andybusse/power-hw/gerbers/README.txt

Student Robotics
Contact: Richard Barlow
Email:   rbarlow@studentrobotics.org
Phone:   XXXXXXXXXXXX
--------------------------------------------------------------------------------
Board Reference:  srobo_power
Board Issue:      A
--------------------------------------------------------------------------------
Board Details:
Bare Board Test:      Yes
Layers:               2
Copper Weight:        1oz
Finish:               Gold
Material:             1.6mm FR4
Solder Resist:        GREEN on 2 sides
Silk Screen:          WHITE on 2 sides
Panelisation:         Manufacturing Panels
Circuits per Panel:   1
--------------------------------------------------------------------------------
Please step up the boards to fit on a panel size no greater than 285mm x 185mm
Add 1mm fiducials to 3 corners of the panel on the top side.
Place 3mm locating holes in each corner of the panel border.
Return the stepped up gerber for the solder paste (*paste.gbr) - Please include
the postions of the fiducials on the stepped up gerber.
--------------------------------------------------------------------------------
Layer Order:
front
back
--------------------------------------------------------------------------------
Gerber Files:
power.front.gbr       - Top Copper Layer
power.back.gbr        - Bottom Copper Layer
power.frontmask.gbr   - Solder Mask Top
power.backmask.gbr    - Solder Mask Bottom
power.frontpaste.gbr  - Solder Paste Top
power.backpaste.gbr   - Solder Paste Bottom
power.frontsilk.gbr   - Silk Screen Top
power.backsilk.gbr    - Silk Screen Bottom
power.outline.gbr     - Board Outline
power.fab.gbr         - Fabrication/Drill Drawing
power.plated-drill.cnc   - Plated Hole Drill Information
power.unplated-drill.cnc - Unplated Hole Drill Information
--------------------------------------------------------------------------------
If there are any problems please contact Student Robotics using the details at
the top of this file.
