andybusse/power-hw/padding.dxf

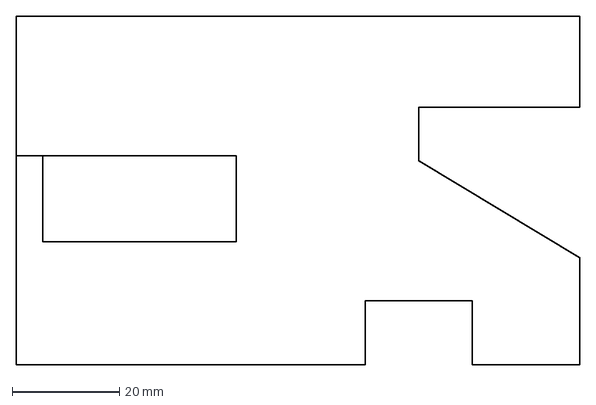
[picture p1: CAD file, 2011-02-26]
padding.dxf
105.0 x 65.0 mm
