andybusse/power-hw/case-devel.dxf

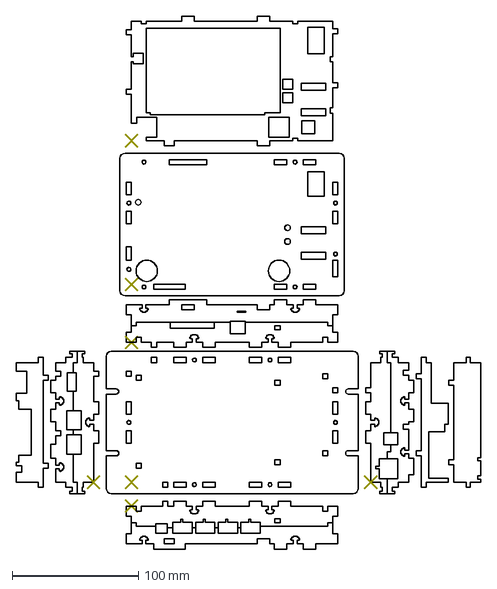
[picture p2: CAD file, 2010-12-02]
case-devel.dxf
368.8 x 423.0 mm
