andybusse/power-hw/(list of files, drawings)

Other design files:
power.pcb
usb-riser/gerbers/outline.pcb
usb-riser/usb-riser.pcb
