andybusse/power-hw/(commit log)

2010-07-20 Add components & sric submodule. Add other misc file
    Ignore itermediate files created by gsch2pcb and backup files from both
    gschem and PCB. Add projectrc/gafrc files for managing symbol/package
    libraries.
2010-07-20 Start schematic. Add battery connector
    Also removed titleblock
    [power.sch]
2010-07-21 Add fuse from the battery. Pull components repo with fuse footprint
    [power.sch]
2010-07-22 Add comment to battery fuse outlining the type/rating to be used
    [power.sch]
2010-07-22 Add netname to fuse protected battery voltage rail
    [power.sch]
2010-07-22 Add reverse polarity protection FET. Pull updated components repo for D_PAK
    [power.sch]
2010-07-22 Change battery connector to sr-cn-battcon. Remove footprint for now
    [power.sch]
2010-07-22 Add charger socket and fuse
    [power.sch]
2010-07-22 Add battery current sense resistor, connect charger to battery
    [power.sch]
2010-07-22 Add FET to detect when the charger is plugged in
    Use a FET to buffer the signal from the charger socket instead
    of just using that pin as a pull-down into the MSP to protect against
    breaking things if the charger is mis-wired. When the battery or charger
    is connected the wrong way around a small current will flow through the
    100k resistor, I think there'll be no problem with this.
    [power.sch]
2010-07-22 Rename 'Vbatt' net to '12V'
    [power.sch]
2010-07-22 Add footprint and comment attribute to charger socket
    [power.sch]
2010-07-22 Add 12V logic rail protected by a 1A fuse
    The 1A fuse will allow roughly 2.4A to be drawn from the 5V BB/USB
    rail. It will take over 30 mins to blow with 2A flowing through it.
    [power.sch]
2010-07-22 Add logic power switch between the 12V and 12V_logic rails
    [power.sch]
2010-07-22 Add 3.3V linear reg
    Use a linear reg off the 12V rail it's only powering the MSP and
    the SRIC LVDS IC. It could be a smaller reg off the 5V rail but it
    would mean the 5V rail could not be controlled by the MSP.
    [power.sch]
2010-07-22 Add power LED to 3.3V rail
    [power.sch]
2010-07-22 Add power LED to 12V rail
    [power.sch]
2010-07-23 Add fuses to protect SRIC 12V line
    Fuse the 'IN' and 'OUT' socket individually. The fuses are rated to
    protect the cable and will allow a maximum of 3.7A to be drawn over
    the interconnect. This works out as 925mA per conductor.
    [power.sch]
2010-07-23 Add motor/pwm rail camcons
    Three camcons for up to four motor boards + a PWM board or two.
    [power.sch]
2010-07-23 Add motor/pwm rail control FET
    [power.sch]
2010-07-23 Add charge-pump for driving motor/pwm rail FET
    As I'm using an n-channel FET to switch the motor/pwm rail a charge-
    pump is required to obtain a high voltage for driving the gate.
    This charge pump uses a dual op-amp as a relaxation oscillator and
    unity gain buffer. The buffer drives a cap/diode network to give
    ~22V on the output.
    [power.sch]
2010-07-23 Add FETs to drive motor/pwm rail FET
    Add a couple of inverters to drive the gate of the motor/pwm rail
    FET.
    [power.sch]
2010-07-23 Add 100k pull-down to input of motor/pwm rail control circuit
    Don't want this thing turning on accidentally
    [power.sch]
2010-07-23 Add 100k pull-up to charger detection FET
    Now that the 3.3V rail exists, there's somewhere to pull it up to.
    [power.sch]
2010-07-23 Add Makefile copied from the motor-hw.git repo
2010-07-23 Add beagleboard symbols
    [power.sch]
2010-07-23 Add values to charge-pump op-amps. Remove incorrect footprint attribute
    Hmm, seems some of the gEDA symbols have footprints already assigned, crazy.
    [power.sch]
2010-07-23 Add SRIC 8P8C connectors and connect up to 12V rail
    Had to add them in separately to allow the power rails to be connected properly.
    [power.sch]
2010-07-23 Give all SRIC lines from 8P8C sockets netnames
    [power.sch]
2010-07-23 Shift SRIC stuff away from everything else, it's going to be quite big
    [power.sch]
2010-07-23 Add SRIC LVDS drivers
    [power.sch]
2010-07-23 Add SRIC data input line termination and protection
    [power.sch]
2010-07-23 Add termination and protection to SRIC token input line
    [power.sch]
2010-07-23 Add protection to SRIC token out lines and connect them to the LVDS driver
    [power.sch]
2010-07-23 Add protection to SRIC data output lines and connect to LVDS driver
    [power.sch]
2010-07-23 Permanently enable token LVDS driver
    [power.sch]
2010-07-23 Add power and decoupling caps for SRIC LVDS IC
    [power.sch]
2010-07-23 Reposition SRIC RJ45 socket values
    [power.sch]
2010-07-23 Add net names to data tx/rx and token in/out lines from LVDS IC
    [power.sch]
2010-07-24 Move 12V rail power LED to make space for current sense circuit
    [power.sch]
2010-07-24 Set value and footprint of current sense resistor
    [power.sch]
2010-07-24 Add filter across current sense resistor
    Has a breakpoint of ~1.7kHz. The signal will be filtered more before
    it enters the MSP. This is just to remove the very high frequency
    components from the edges of the PWM on the motor boards.
    [power.sch]
2010-07-24 Add current sense amplifier to measure current to/from the battery
    The amplifier has a gain of 50 and the sense resistor (1m ohm) gives
    1mV/A therefore the output of the amplifier has the scale 50mV/A.
    [power.sch]
2010-07-25 Add UART and RESET netnames to BB expansion header
    [power.sch]
2010-07-25 Add LPF to output of current sense amp
    Has a breakpoint of 1.026kHz
    [power.sch]
2010-07-25 Add potential divider to obtain current sense diff. amp. reference voltage
    The potential divider gives 0.25V from the VREF+ pin on the MSP which
    will be at 1.5V when measuring the current.
    [power.sch]
2010-07-25 Add netname to current sense output
    [power.sch]
2010-07-26 Add potential divider to measure battery voltage
    [power.sch]
2010-07-27 Add LCD data and backlight connectors to schematic
    [power.sch]
2010-07-27 Add 5V power switching circuitry to LCD 5V input
    The datasheet for the display says that the 5V rail must be applied
    after the 2.5V rail.
    [power.sch]
2010-07-27 Add values and footprints to the LCD connectors
    [power.sch]
2010-07-27 Add 2.5V LDO regulator for LCD power
    [power.sch]
2010-07-27 Increase space between the beagleboard and LCD symbols to fit in translators
    [power.sch]
2010-07-27 Add LCD backlight SMPS
    [power.sch]
2010-07-27 Disconnect backlight driver shutdown pin from 5V rail. Add pull-down
    We need to be able to turn the backlight driver on after everything
    else is powered up and the output cap of the driver has charged to
    prevent a large inrush current. It also means we can vary the
    brightness of the backlight.
    [power.sch]
2010-07-27 Move backlight SMPS higher up to allow for level translators
    [power.sch]
2010-07-27 Add LCD level translators
    [power.sch]
2010-07-27 Add power symbols for level translators
    [power.sch]
2010-07-27 Change all occurrences of 'IC' refdeses to 'U' refdeses to keep consistency
    [power.sch]
2010-07-27 Reposition level translator refdeses and values
    [power.sch]
2010-07-27 Set value of 2.5V LDO regulator
    [power.sch]
2010-07-27 Add 2u2 cap to the 5V rail just before the LCD power FET
    [power.sch]
2010-07-28 Add values to the beagleboard expansion and LCD header symbols
    [power.sch]
2010-07-29 Rename LCD 1.8V rail to '1V8_LCD' and add netname to main 1V8 rail
    [power.sch]
2010-07-29 Add EEPROM for identifying the power board from the beagleboard
    The BB SRM says that we should have an EEPROM connected to the I2C
    lines of the expansion header so that the board can be identified
    and pin muxes set appropriately.
    [power.sch]
2010-07-29 Add MSP430F247
    [power.sch]
2010-07-29 Connect power and add decoupling caps to MSP
    [power.sch]
2010-07-29 Connect analogue reference voltages to MSP and reference decoupling caps
    [power.sch]
2010-07-29 Connect Vsense and Isense nets to MSP analogue inputs
    [power.sch]
2010-07-29 Add piezo sounder to TA1 outputs
    Can drive it either differentially (which should be louder) by
    populating the resistor to the P1.6 TA1 pin or single-ended with
    the resistor to ground.
    [power.sch]
2010-07-29 Add footprint to piezo buzzer. Add comment explaining piezo resistors
    [power.sch]
2010-07-29 Connect SRIC to MSP, use same UART as pc-sric adapter board
    [power.sch]
2010-07-29 Tie reset line high with 100k resistor
    [power.sch]
2010-07-29 Add 4-wire JTAG programming header for MSP
    [power.sch]
2010-07-29 Give JTAG programming header a value and footprint
    [power.sch]
2010-07-29 Shift 'TX_EN', 'TO' and 'TI' SRIC lines to the same pins as the pc-sric board
    Not massively important but might prove useful.
    [power.sch]
2010-07-29 Add 2 bit level translator to the BB UART and connect it to the MSP
    The level translator is in an SSOP8 package but the gEDA SSOP8
    footprint is way too wide so I've selected the TSSOP8 footprint, it
    seems to fit the drawing much better. NEEDS TO BE CHECKED.
    The TX and RX lines from the BB connect to their opposite counterparts
    on the MSP. I.E. BB TX to MSP RX, BB RX to MSP TX.
    The BB_TX and BB_RX lines are now on the 3.3V side of the translator.
    [power.sch]
2010-07-29 Add red LED to Token In line
    [power.sch]
2010-07-29 Connect up charger detection to the MSP
    [power.sch]
2010-07-29 Connect up the motor rail enable input to the MSP
    [power.sch]
2010-07-30 Connect BB expansion header signals to MSP
    Connected the beagleboard's reset line to the MSP via a FET to pull
    it low. The REGEN line from the beagleboard is open-drain and can be
    used to detect if the beagleboard is powered on. The other two lines
    that we have access to on the beagleboard (that are not MMC/SD related)
    have been tied to the MSP via some bi-directional level translation FETs.
    [power.sch]
2010-07-30 Refactor schematic - move LCD stuff into a separate schematic
    power-lcd.sch now contains all LCD related circuitry: level translation,
    2.5V regulator, 5V delayed power switch and 15mA backlight driver.
    [power-lcd.sch, power.sch]
2010-07-30 Refactor schematic - Move MSP and SRIC parts out to separate schematic
    power-msp.sch now contains the MSP, SRIC and beagleboard level
    translation stuff.
    [power-msp.sch, power.sch]
2010-07-30 Rename 'power.sch'. It now contains all the switching/regulation stuff
    [power-power.sch]
2010-07-30 Rearrange stuff in power-power to increase readability
    [power-power.sch]
2010-07-30 Add 5V SMPS to power-power schematic, for BB and USB
    [power-power.sch]
2010-07-30 Add crowbar circuit to 5V rail. Will blow the 1A logic rail fuse
    If the voltage on the 5V rail rises above 5.5V the thyristor will turn
    on and clamp the 12V_logic rail to ground, causing the 1A fuse to blow.
    [power-power.sch]
2010-07-30 Add a comment next to the crowbar circuit mentioning the trip voltage
    [power-power.sch]
2010-07-30 Correct a couple of values
    Had sr-i-10u-2a instead of sr-l-10u-2a and
    sr-c-10p instead of sr-c-10p-50v
    [power-power.sch]
2010-07-31 Add power LED to the 5V rail
    [power-power.sch]
2010-07-31 Add green LED to motor rail
    [power-power.sch]
2010-07-31 Add 100nF decoupling cap to LCD 2.5V rail for the LCD itself
    [power-lcd.sch]
2010-07-31 Remove LED from 12V rail
    It would be illuminated constantly when the battery is connected.
    This would cause the battery to be completely drained if left plugged
    in for a week, which could happen between mentoring sessions.
    [power-power.sch]
2010-07-31 Power motor rail FET charge pump from the 12V_logic rail as it's switched
    The only load on the main 12V rail when the kit is switched off is
    the voltage sense potential divider and the 100k pull-up for the
    charger detection FET. Together they draw about 260uA, giving a shelf
    life of 1.4 years with the battery left connected. I'm pretty certain
    the self-discharge rate of the battery is higher than this.
    [power-power.sch]
2010-07-31 Rename 'BL_CTRL' net to 'BL_EN' and add in/out symbols linking schematics
    [power-lcd.sch, power-msp.sch]
2010-07-31 Add in/out symbols linking 'MOTOR_EN' signal across schematics
    [power-msp.sch, power-power.sch]
2010-07-31 Add in/out symbols for 'Vsense' and 'Isense' between msp and power schematics
    [power-msp.sch, power-power.sch]
2010-07-31 Add in/out symbols for 3V3 and 5V rails
    [power-msp.sch, power-power.sch]
2010-07-31 Add 100nF decoupling cap to 1.8V rail for 2 bit level translator
    [power-msp.sch]
2010-07-31 Add 100nF cap on 3.3V rail for 2 bit level translator
    [power-msp.sch]
2010-07-31 Add in/out symbols to link VREF+ voltage from MSP to current sense circuit
    [power-msp.sch, power-power.sch]
2010-07-31 Add in/out symbols for 'CHARGER_DETECT' signal to MSP
    [power-msp.sch, power-power.sch]
2010-07-31 Add 100R terminating resistor to data out differential lines on SRIC
    Oops, almost missed this. The data lines require termination at both
    ends to ensure there are no reflections.
    [power-msp.sch]
2010-07-31 Add 160k pull-up resistors to both ends of the data differential lines
    Should stop the bus from floating and erroneous data being pumped into
    boards when nothing is transmitting.
    [power-msp.sch]
2010-07-31 Add 8MHz crystal to MSP X2 in/out pins
    Could possibly be a 16MHz crystal to improve SRIC data throughput.
    [power-msp.sch]
2010-07-31 Move CHARGER_DETECT line to an interrupt capable pin on the MSP
    [power-msp.sch]
2010-07-31 Add in/out symbols for 5V_EN signal from MSP to SMPS
    [power-msp.sch, power-power.sch]
2010-07-31 Add test point to EEPROM WP line to allow it to be written to
    The test point needs to be shorted to ground to allow the EEPROM
    to be written to.
    [power-msp.sch]
2010-07-31 Add 15V TVS diodes across both the 'in' and 'out' SRIC 12V lines
    Should absorb transients coming from noise induced in the cat5 cables.
    [power-power.sch]
2010-07-31 Add red 0603 debugging LED
    [power-msp.sch]
2010-07-31 Add red LED across main fuse to show when it's blown
    When the fuse blows current will flow through the LED. A maximum of
    10mA will flow through the rest of the kit once the fuse blows. As
    the current draw of the kit is so low when the logic power switch is
    off the blown fuse LED will go out (in theory).
    [power-power.sch]
2010-07-31 Connect charge-pump output to MSP via a pot. divider to allow measurements
    It could be useful to monitor the output of the charge-pump to ensure
    it is functioning. If it isn't working then we don't want to try and
    turn the motor rail on as it could damage the n-channel FET.
    [power-msp.sch, power-power.sch]
2010-07-31 Add two rotary encoders
    The arrangement of pull-ups and low-pass filter is as shown in the
    datasheet.
    [power-msp.sch]
2010-07-31 Add 3 general purpose LEDs to the MSP. 2 red, 1 yellow
    [power-msp.sch]
2010-07-31 Add a button (which, incidentally, should not be pressed) to an interrupt pin
    Will most likely be a 'menu' button to get the user back to some
    kind of start screen quickly.
    [power-msp.sch]
2010-08-01 Drive piezo buzzer with a FET from the 12V_logic rail
    It should be much louder and uses one less interrupt capable
    pin on the MSP.
    [power-msp.sch]
2010-08-01 Add in/out symbols linking the 12V_logic rail to the MSP schematic
    [power-msp.sch, power-power.sch]
2010-08-01 Move second rotary encoder signals to the upper 3 bits of port 1
    It means all of the button signals can be groups together. With
    the piezo control line in the middle unfortunately.
    [power-msp.sch]
2010-08-01 Add two more general purpose buttons
    [power-msp.sch]
2010-08-01 Change push buttons to use new 4 pin symbol
    [power-msp.sch]
2010-08-01 Attach a footprint attribute to all of the push buttons
    [power-msp.sch]
2010-08-01 Connect motor rail to MSP analogue input via a pot. divider
    Allows us to monitor the motor rail voltage if we so wish.
    [power-msp.sch, power-power.sch]
2010-08-01 Spread the components out on the power-msp schematic to make it less cluttered
    [power-msp.sch]
2010-08-01 Add pull-down to the transmitter enable pin of the SRIC data LVDS driver
    [power-msp.sch]
2010-08-01 Add a fourth motor rail camcon for custom electronics
    [power-power.sch]
2010-08-01 Add a charging LED. Illuminates when the charger is plugged in
    Unfortunately there is no way I can think of to have an LED light
    up when the battery is charging and the power board is switched off.
    The best we can have is an LED which lights up when the charger is
    plugged in. If the power board is switched on then we can have
    another LED show the charging status and display something on the
    screen.
    [power-power.sch]
2010-08-01 Revert "Add a charging LED. Illuminates when the charger is plugged in"
    This reverts commit 69c8200de19814e232f60e632d0b3e12e14cdaa3.
    It will be too misleading to have an LED that lights up when you plug the
    charger in as it doesn't necessarily mean that the battery is charging.
    The charger could be off, battery not plugged in, fuse blown, etc.
    We'll just have to live with only showing the charging status when the
    power board is switched on.
    [power-power.sch]
2010-08-01 Update projectrc and Makefile to use separate schematic pages
2010-08-01 Remove incorrect second footprint attribute from 8P8C sockets
    [power-msp.sch]
2010-08-01 Correct footprint name on LCD 2.5V LDO regulator
    It was set to 'SOT25-2' which was the old name that didn't work due
    to the hyphen. It's now 'SOT25_2'
    [power-lcd.sch]
2010-08-01 Rename the 'Logic Power Switch' to 'Power Switch' and change its footprint
    The logic power switch is now the only switch used to control the power
    to the kit, there is no more 'charge/run' switch. This means we can now
    safely call it the 'power switch' without causing confusion.
    It will be integrated into the power board casing assembly and will connect
    to the power board via a 2 way header. The 2 way header is a right angle
    type due to the restricted height in the power board case.
    [power-power.sch]
2010-08-01 Change a couple of p-channel FETs to a cheaper and smaller alternative
    SOT323 so much nicer than SOT23. Couldn't change the p-channel FET in the
    motor rail control circuit due to it having to cope with voltages over 20V.
    [power-msp.sch, power-power.sch]
2010-08-02 Add 2 more LEDs. One red one yellow. For general purpose use
    There's now 5 LEDs hanging off the MSP (not counting the SRIC activity
    LED). One of these can be used to indicate the charging status. The
    other four can be for use in the user code.
    [power-msp.sch]
2010-08-02 Add connector to 5V rail for a powered USB hub
    I've measured the current drawn from a USB port though on of the
    Belkin hubs with a webcam and memory stick plugged in. It comes to
    around 350mA. When attempting to plug a keyboard in the hub cuts
    power to one of the other ports so it needs to be powered to support
    more than the normal webcam+memory stick.
    [power-power.sch]
2010-08-02 Change value and footprint of the USB hub power connector
    Use the smaller 3.81mm 'minicamcon' due to it being 5V. All camcons
    have 12V on them, everything else uses the 3.81mm connectors.
    [power-power.sch]
2010-08-02 Add footprint attribute to battery connector
    [power-power.sch]
2010-08-02 Bung on more LEDs for good measure
    [power-msp.sch]
2010-08-02 Assign refdeses to all components with sheets starting from 100, 200 & 300
    [power-lcd.sch, power-msp.sch, power-power.sch]
2010-08-02 Update components repo with LCD and switch footprints
2010-08-02 Change D-PAK FETs to use nmos-4 symbol which has numbers for pin numbers
    As opposed to letters like in nmos-3 :S
    [power-power.sch]
2010-08-02 Correct footprint for power switch
    [power-power.sch]
2010-08-02 Correct refdes of BB expansion header
    Had two bealgeboards in the layout for a moment then!
    [power-msp.sch]
2010-08-02 Add PCB layout with components dispersed
    That's a LOT of components, and a LOT of nets. This should be fun.
    [power.pcb]
2010-08-02 Give board a name to allow screen capture script to ID the correct window
    I'm going to record the process of laying out the power board to make a
    cool video. A screenshot is taken of the PCB window every 2 seconds.
    I've used ImageMagick's 'import' program which allows you to capture a
    certain window by passing its name, setting the board name changes the
    window title allowing it to be uniquely identified.
    [power.pcb]
2010-08-03 Add decoupling caps to charge-pump op-amp and high-side current amp
    [power-power.sch]
2010-08-03 Insert new decoupling caps into layout
    [power.pcb]
2010-08-03 Move all of the components out of the way
    Moved everything except for the beagleboard footprint to the bottom of the layout area.
    [power.pcb]
2010-08-03 Add PSP LCD and rocker switch outlines
    [power.pcb]
2010-08-03 Move beagleboard onto rear of board and position LCD over it
    [power.pcb]
2010-08-03 Add rough ouline of case and board. Move LCD to a more central position
    [power.pcb]
2010-08-03 Place motor rail camcons, battery connector, charger socket and big fuses
    [power.pcb]
2010-08-03 Place USB 5V mini-camcon and SRIC 8P8C sockets
    [power.pcb]
2010-08-03 Place rotary encoders
    Had to shift the camcons and beagleboard to the left to fit them in.
    Also moved the LCD up slightly to make space underneath.
    [power.pcb]
2010-08-03 Move SRIC 8P8C sockets down to leave space for an SD card in the BB
    [power.pcb]
2010-08-03 Place power switch header
    [power.pcb]
2010-08-03 Place LCD FPC connectors
    [power.pcb]
2010-08-03 Place buttons
    Couldn't fit them all in down one side of the screen so there's one
    in the top left corner, can be some kinda 'menu' button. And two in
    the bottom right, which can be OK/Cancel.
    [power.pcb]
2010-08-03 Place MSP JTAG header
    [power.pcb]
2010-08-03 Place piezo buzzer
    It's on the edge of the board, above the mini-USB socket on the BB.
    Holes will need to be made in the side panel to allow the sound out.
    [power.pcb]
2010-08-03 Place the 12V logic rail fuse. Last through-hole component placed
    [power.pcb]
2010-08-03 Move components into three clusters, one for each schematic
    [power.pcb]
2010-08-03 Lock all components currently placed on the board
    Don't want to accidentally move anything important.
    [power.pcb]
2010-08-03 Place and route copper around reverse polarity protection FET
    [power.pcb]
2010-08-03 Round battery GND to the charging socket
    [power.pcb]
2010-08-03 Connect battery connector up to main power fuse
    [power.pcb]
2010-08-03 Place and route charger detection FET
    [power.pcb]
2010-08-03 Place and route main fuse status LED + resistor
    [power.pcb]
2010-08-03 Connect 12V rail through sense resistor and FET to camcons
    [power.pcb]
2010-08-03 Connect GND to all camcons. Motors now have power
    [power.pcb]
2010-08-03 Rejig motor rail FET and current sense resistor to give wider traces
    The copper below the motor rail FET where it goes to the camcons was
    too narrow. The FET has been moved up to give more space below.
    [power.pcb]
2010-08-04 Add more heatsinking to big FETs
    Added a load of vias to copper on the other side of the board to
    increase the surface area, should give around 35-40 degrees/W now.
    [power.pcb]
2010-08-04 Upgrade the rev. polarity and motor rail FETs to something more beefy
    The 35A FET just wasn't enough, 160A is much better :D
    MOSFET datasheets are very misleading, you hit the thermal limit of
    the package way before the maximum current D: These ones will only
    dissipate a maximum of 2W when carrying 25A.
    [power-power.sch, power.pcb]
2010-08-04 Place and route current sense amp
    [power.pcb]
2010-08-04 Route 12V to power switch and rev. polarity FET
    [power.pcb]
2010-08-04 Place and route charge pump
    [power.pcb]
2010-08-04 Place and route motor rail FET driver circuit
    [power.pcb]
2010-08-04 Place and route motor rail power LED
    [power.pcb]
2010-08-04 Place and route 3.3V reg + 3.3V power LED
    [power.pcb]
2010-08-04 Connect 3.3V to current sense amp
    [power.pcb]
2010-08-04 Place SRIC fuses and route 12V from power switch
    [power.pcb]
2010-08-04 Begin routing of LCD data lines. Fiddle with slotting to make things easier
    [power-lcd.sch, power.pcb]
2010-08-04 Change LCD data and BB LCD symbols to make routing easier
    They're still connected to each other the same but the routing is much
    easier as there are no crossing rats between the LCD connector and the
    level translators.
    [power.pcb]
2010-08-04 Place level translators and route colour signals from them to the LCD
    I've placed the level translators at 45 degrees to make the routing
    cleaner. It should be possible to make all of the connections to the
    LCD connector without any vias, there will however be millions of vias
    between the BB and the level translators.
    [power.pcb]
2010-08-04 Swap level translators used for DISP and CLK lines
    Removes some crossing rats
    [power-lcd.sch, power.pcb]
2010-08-04 Route LCD control lines
    [power.pcb]
2010-08-04 Route LCD colour and control signals from BB to level translators
    [power.pcb]
2010-08-04 Connect 1.8V from BB to level translators
    [power.pcb]
2010-08-04 Connect all GND pins on the level translators
    [power.pcb]
2010-08-04 Conenct GND pins on LCD data connector
    [power.pcb]
2010-08-04 Connect 2.5V pins together on level translators
    [power.pcb]
2010-08-04 Place decoupling caps next to the level translators on both both rails
    [power.pcb]
2010-08-04 Update beagleboard footprint with corrected soldermask clearance around pins
    [power.pcb]
2010-08-04 Add decoupling cap to LCD connector on 2.5V rail and pull-up for PUP line
    [power.pcb]
2010-08-04 Route 2.5V regulator for LCD
    [power.pcb]
2010-08-04 Place and route LCD 5V switch
    [power.pcb]
2010-08-04 Route and layout LCD backlight driver
    [power.pcb]
2010-08-05 Place 5V LED in preparation for a working SMPS design
    [power.pcb]
2010-08-05 Place and route ID EEPROM
    [power.pcb]
2010-08-05 Place and route BB reset FET
    [power.pcb]
2010-08-05 Place and route SRIC fuses, current limit resistors and termination resistors
    [power.pcb]
2010-08-05 Place and route SRIC differential line TVS diodes
    [power.pcb]
2010-08-05 Add keepout area for USB from BB
    The box I've drawn shows where the header is most likely to be located
    to connect to the USB port on the beagleboard.
    [power.pcb]
2010-08-05 Place SRIC LVDS IC and connect up differential lines
    [power.pcb]
2010-08-05 Place decoupling caps for LVDS IC, connect up GND around SRIC
    [power.pcb]
2010-08-05 Place and route token LED
    [power.pcb]
2010-08-05 Place pull-down on TX_EN pin of data LVDS driver
    [power.pcb]
2010-08-05 Place and route UART level translator
    [power.pcb]
2010-08-05 Place and route MOSFET level translators for BB<->MSP GPIO lines
    [power.pcb]
2010-08-05 Fix board outline size and move connectors to edge. Remove case_outline layer
    The board outline was smaller than the case outline, which wasn't right.
    The case outline was superfluous so I've deleted it. The board outline
    is now 160x95mm and the connectors are all positioned at the very edge
    to give 4mm of overhang.
    [power.pcb]
2010-08-05 Expand polygons to the edge of the now correctly sized board
    [power.pcb]
2010-08-05 Position MSP and route bottom left rotary encoder signals over to it
    [power.pcb]
2010-08-05 Spin the JTAG header 180 degrees and connect JTAG signals to MSP
    [power.pcb]
2010-08-05 Fix some DRC errors that appeared over the last few days
    [power.pcb]
2010-08-05 Route SRIC control and data lines to MSP
    [power.pcb]
2010-08-05 Connect power to SRIC, both 12V and 3.3V
    [power.pcb]
2010-08-05 Make room for the BB UART and GPIO lines next to the big bundle of traces
    I should have planned ahead better, that took ages and was very boring :(
    [power.pcb]
2010-08-05 Fix an incorrect trace around the rotary encoder filter
    [power.pcb]
2010-08-05 Route BB UART and GPIO lines to MSP
    [power.pcb]
2010-08-05 Place and route crystal for MSP
    Placed it on the rear of the power board due to it being too high to
    fit under the LCD.
    [power.pcb]
2010-08-05 Place and route components for driving piezo buzzer
    [power.pcb]
2010-08-05 Place a button filter and route the signal to the MSP
    [power.pcb]
2010-08-05 Connect two buttons on the right of the LCD to the MSP
    [power.pcb]
2010-08-05 Place and route SRIC activity/debugging LED
    [power.pcb]
2010-08-05 Place two red LEDs next to the two buttons on the right of the LCD
    [power.pcb]
2010-08-05 Clear space next to the MSP for the second rotary encoder filter
    [power.pcb]
2010-08-05 Place components for second rotary encoder filter and route it all
    [power.pcb]
2010-08-05 Connect reset and 'regen' signals from BB to MSP
    [power.pcb]
2010-08-05 Place red LED next to button to the left of the LCD. Route it to the MSP
    [power.pcb]
2010-08-05 Place and route decoupling caps on MSP
    [power.pcb]
2010-08-06 Route Vref+ to the current sense amp and the charger_detect line
    [power.pcb]
2010-08-06 Place MSP reset line pull-up resistor
    [power.pcb]
2010-08-06 Connect up most of the grounds on the rear of the PCB
    I've connected all of the ground net together with thick traces
    before adding a plane to ensure that everything is well grounded.
    [power.pcb]
2010-08-06 Place and route LED for charging indication
    It's a red LED next to the two green power LEDs (3.3V and 5V). It's
    connected to a pin on the MSP so it'll only be able to tell you if
    the battery is charging when everything is switched on.
    [power.pcb]
2010-08-06 Place the last three LEDs below the screen in a row. For student use
    [power.pcb]
2010-08-06 Route 3.3V to MSP
    [power.pcb]
2010-08-06 Move crystal to make room for SMPS on the rear of the PCB
    [power.pcb]
2010-08-06 Place and route 12V rail measurement potential divider resistors
    [power.pcb]
2010-08-06 Connect GND pins on MSP
    [power.pcb]
2010-08-06 Connect GND to current sense circuit. Place pull-up on charger detect line
    [power.pcb]
2010-08-06 Place Isense line filter and route to MSP
    [power.pcb]
2010-08-06 Place Vpump measurement potential divider and route to MSP
    [power.pcb]
2010-08-06 Place motor rail measurement potential divider and route to MSP
    [power.pcb]
2010-08-06 Place and route SRIC 12V rail TVS diodes
    [power.pcb]
2010-08-06 Move layout to top left corner and reduce size of canvas
    [power.pcb]
2010-08-06 Route LCD backlight enable line to MSP
    [power.pcb]
2010-08-06 Route last few remaining 3.3V and GND rats
    [power.pcb]
2010-08-06 Route MOTOR_EN line to the MSP
    [power.pcb]
2010-08-06 Move USB hub power connector to the bottom edge
    There isn't enough space at the top left for the USB socket and
    the power connector.
    [power.pcb]
2010-08-07 Add M3 mounting holes
    [power.pcb]
2010-08-07 Fix some DRC errors that have been masked for ages
    A ton of DRC error with the level translator footprints due to the
    pads having exactly 0.2mm of space between them were masking some
    actual errors in the LCD data line wiring.
    [power.pcb]
2010-08-07 Move fuse blown LED out of some high-current traces
    The LED next to the main fuse was cutting into a fat trace going to
    the sense resistor, significantly reducing its width.
    [power.pcb]
2010-08-07 Expand high current copper areas to fill available space
    [power.pcb]
2010-08-08 Move USB power connector to MSP schematic sheet
    [power-msp.sch, power-power.sch, power.pcb]
2010-08-08 Add protection against 12V being injected into USB hub power connector
    The TS2431 will pull the gate of the FET to ground when the voltage
    on the USB hub power connector rises above 5.247V (5.303-5.193V with
    1% resistors).
    [power-msp.sch, power.pcb]
2010-08-08 Add USB-A socket and 4 way header to take BB USB port to the outside
    A little board will plug into the BB USB port which has a 4 way socket
    or header of some kind on which will mate with the header/socket on the
    power board. The power board conencts the signals to a USB-A socket
    along with a protected 5V rail.
    [power-msp.sch]
2010-08-08 Change symbol for USB A socket in power-msp schematic to custom symbol
    The custom symbol has the shield pin shown which needs to be conencted
    to ground at the host end.
    [power-msp.sch]
2010-08-08 Update PCB layout with USB socket and header
    [power.pcb]
2010-08-08 Squeeze USB A socket on the back of the board
    Just about managed to fit it into the top left corner on the back of
    the board. Had to move the top left push button as it was in the way
    of one of the shield pins.
    [power.pcb]
2010-08-08 Connect BB USB header data lines to USB socket
    Tried to keep them the same distance apart and the same length.
    [power.pcb]
2010-08-08 Place and route USB 5V protection components
    [power.pcb]
2010-08-08 Remove traces on outline layer around BB USB header
    They were only there to mark a keep-out zone. Don't want a chunk of the
    board missing when we send it off to be made ;)
    [power.pcb]
2010-08-08 Position refdeses on rear of PCB
    [power.pcb]
2010-08-08 Place refdeses on front of PCB
    [power.pcb]
2010-08-08 Add a couple of 22uF caps to the 5V_USB rail
    [power-msp.sch, power.pcb]
2010-08-08 Place and route 5V_USB decoupling caps
    [power.pcb]
2010-08-08 Swap LCD 5V rail p-channel FET for cheaper and better alternative
    This one has a lower Rdson and isn't a component that Farnell are
    getting rid of like the last one. It's also cheaper.
    [power-lcd.sch, power.pcb]
2010-08-08 Add usb-riser dir for the little USB board from the BB
    This dir will contain the design of the little board which plugs into
    the beagleboard allowing the power board to connect to it.
2010-08-08 Add very simple schematic for the beagleboard USB riser board
    [usb-riser.sch]
2010-08-08 Generate PCB layout and set up DRC/layers/units
    [usb-riser.pcb]
2010-08-08 Complete layout of usb riser board
    That was easy :D
    [usb-riser.pcb]
2010-08-09 Fix positioning of newly replaced p-channel FET Q100 refdes
    [power.pcb]
2010-08-09 Add component and solder side ground plane layers
    [power.pcb]
2010-08-09 Begin adding ground plane to top side of PCB
    [power.pcb]
2010-08-09 Add some more ground plane to the top of the PCB
    [power.pcb]
2010-08-09 Fix some polygon related DRC errors
    [power.pcb]
2010-08-09 Add more ground plane to the top of the PCB
    [power.pcb]
2010-08-09 Add ground plane underneath LCD level translators
    [power.pcb]
2010-08-09 Add ground plane on top of PCB around SRIC components
    [power.pcb]
2010-08-09 Add ground plane around top edge of the top side
    [power.pcb]
2010-08-09 Fill in last few blank areas on the top side with ground plane
    [power.pcb]
2010-08-09 Update FPC connector footprints to ones with soldermask clearance around pads
    [power.pcb]
2010-08-09 Move BB USB header footprint to where it most likely needs to be
    I won't know for sure until I've measured the actual plug that we're
    going to use, but after taking some measurements from a USB memory
    stick with an almost identical plug I think I've got the positioning
    about right.
    [power.pcb]
2010-08-09 Begin design of the power board case. Draw base
    [case.dxf]
2010-08-09 Add blank side panels to case design
    [case.dxf]
2010-08-09 Add drawing of board stack in the power board case
2010-08-09 Add T-slots and holes between side panels and base of case
    [case.dxf]
2010-08-09 Add cut-outs on 'north' side panel for mini-USB and piezo
    [case.dxf]
2010-08-09 Add cut-outs for 8P8C and USB sockets on 'east' side panel of case
    [case.dxf]
2010-08-09 Add cut-outs for camcons and mini-camcon on 'south' side panel of case
    [case.dxf]
2010-08-09 Add cut-outs for battery camcon and charging jack to 'east' side panel of case
    Yes, this is the actual east side. Looks as if I can't remember my
    cardinal directions, that other commit for the 8P8C and USB should
    have been 'west' side panel :(
    [case.dxf]
2010-08-09 Add text next to power/charging LEDs identifying them
    [power.pcb]
2010-08-10 Add notches for camcon locking tabs in case side panel
    [case.dxf]
2010-08-10 Add notch to battery camcon cut-out for locking tab on case side panel
    [case.dxf]
2010-08-10 Split side panels and add interlocking tabs at the ends
    [case.dxf]
2010-08-10 Add cable tie lugs to all four corners of the case
    [case.dxf]
2010-08-10 Add T-slots and tabs to top of 'east' and 'west' side panels of case
    [case.dxf]
2010-08-10 Add T-slots and tabs to top of 'north' and 'south' side panels of case
    [case.dxf]
2010-08-10 Add unique locating tabs to the bottom of the side panels
    Should prevent them being assembled in correctly.
    [case.dxf]
2010-08-10 Replace non-working 5V SMPS with a working design
    Yey, a working SMPS design at last. It has a current limit of 1.5A
    and runs at about 250kHz.
    [power-power.sch]
2010-08-10 Update PCB layout with new SMPS components
    [power.pcb]
2010-08-10 Place and route overvoltage crowbar components
    [power.pcb]
2010-08-10 Finish routing all nets!
    [power.pcb]
2010-08-10 Resize canvas to fit finished size of board
    [power.pcb]
2010-08-10 Position refdeses around SMPS and crowbar components
    [power.pcb]
2010-08-10 Add copper areas around SMPS inductor and FET to act as a heatsink
    [power.pcb]
2010-08-10 Remove individual ground plane polygons from the rear of the board
    [power.pcb]
2010-08-11 Add ground plane to rear side of PCB
    [power.pcb]
2010-08-11 Add lots of vias to strongly link ground planes on top and bottom layers
    [power.pcb]
2010-08-11 Add copper area on rear of PCB as heatsink for 3V3 reg and link with vias
    [power.pcb]
2010-08-11 Move JTAG header refdes so that it's visible once soldered on
    The footprint is slightly too short and the refdes would have been
    obscured by the header when it was soldered onto the board.
    [power.pcb]
2010-08-11 Add identifying text to PCB layout
    [power.pcb]
2010-08-11 Re-route a few traces to get rid of some narrow points in the ground plane
    [power.pcb]
2010-08-11 Add gerbers used to manufacture first prototype
    [power.back.gbr, power.front.gbr, power.outline.gbr]
2010-08-11 Update PCB layout with 'nopaste' test point footprint
    [power.pcb]
2010-08-12 Add case top panel to drawing
    [case.dxf]
2010-08-12 Add bolt holes and slots for tabs into top panel of case
    [case.dxf]
2010-08-12 Add holes for rotary encoder knobs in top panel of case
    [case.dxf]
2010-08-12 Add cut-outs in case top panel for automotive fuses
    [case.dxf]
2010-08-12 Add holes for buttons into top panel of case
    [case.dxf]
2010-08-12 Add cut-out for power switch in case top panel
    [case.dxf]
2010-08-12 Add LCD frame panel to case drawing
    [case.dxf]
2010-08-12 Add tabs to sides of LCD frame and locating holes in side panels of case
    [case.dxf]
2010-08-12 Add cut-out for LCD in LCD frame panel of case
    [case.dxf]
2010-08-12 Add cut-outs in LCD frame panel for rotary encoder bodies
    [case.dxf]
2010-08-12 Add cut-outs in LCD frame panel for automotive fuses
    [case.dxf]
2010-08-12 Add cut-outs into LCD frame panel of case for push buttons
    [case.dxf]
2010-08-12 Add cut-out in LCD frame panel for power switch
    [case.dxf]
2010-08-12 Add cut-out in LCD frame panel for the long pins on the large battery camcon
    [case.dxf]
2010-08-12 Add slots into base of case for fixing to the robot
    I've added slots rather than fixed holes to allow the board to be
    more easily removed. Only two screws need to be taken out to remove
    the case as it can just slide off the other two.
    [case.dxf]
2010-08-13 Remove value from BB LCD header to fix BOM generation
    The BOM script cannot determine that U103 in the LCD schematic and U103
    in the MSP schematic are the same component and should only be counted
    once. I've changed the BB LCD header value to 'sr-nothing' so that only
    one lot of headers get put into the BOM.
    [power-lcd.sch]
2010-08-13 Move each case panel onto its own layer
    [case.dxf]
2010-08-13 Add origin markers to all side panels of case drawing
    They allow the panels to be correctly positioned by OpedSCAD to
    produce a 3D model of the case.
    [case.dxf]
2010-08-13 Add dimensions layer and add dims for internal volume
    Used by OpenSCAD to position the sides correctly.
    [case.dxf]
2010-08-13 Move lines that cut the side panels in half to a separate layer
    OpenSCAD doesn't like seeing those lines as there is no continuous
    contour for each panel.
    [case.dxf]
2010-08-13 Fix problem with origin cross on inner_top_origin layer
    For some reason OpenSCAD wasn't picking up this cross. Deleting and
    re-creating the layer fixed it.
    [case.dxf]
2010-08-13 Add OpenSCAD script for generating a 3D model of the case
    [case.scad]
2010-08-23 Add unity-gain buffer to the input of current sense amp reference
    It turns out the reference voltage needs to be fairly low impedance to ensure
    that the battery voltage does not affect the reference voltage. This op-amp
    will give a very low impedance reference for the current sense amp, making the
    measured current completely independant of the battery voltage.
    [power-power.sch]
2010-08-23 Give charge-pump dual op-amp an explicit footprint
    Due to the symbol including a footprint attribute I didn't notice that it
    wasn't set to the correct value for the part, which is SSOP. Rather than
    changing the footprint to the correct value and updating the layout I will
    just change the component to be an SO8 variety.
    [power-power.sch]
2010-08-23 Flip the 5V SMPS feedback resistors around
    Got the feedback resistors the wrong way around so it was producing about 1.6V
    [power-power.sch]
2010-08-23 Switch LCD backlight driver IC footprint to one with pin 1 marked on
    [power-lcd.sch]
2010-08-23 Change 5V SMPS feedback cap to 10pF
    The 220pF one made it more prone to running at a much higher frequency
    than desired (~1.5MHz compared to 250kHz).
    [power-power.sch]
2010-08-27 Flip 12V_logic fuse onto the back of the board
    It is too tall to fit between the top of the board and the front of the case.
    [power.pcb]
2010-08-27 Update PCB layout with changed values and footprints
    The LCD backlight driver IC now has a better footprint which shows the orientation.
    [power.pcb]
2010-08-27 Remove erroneous duplicate footprint attribute from LCD backlight driver IC
    [power-lcd.sch]
2010-08-27 Place and route current sense amp reference voltage buffer
    [power.pcb]
2010-09-01 Update ATO fuse holder footprints on layout
    They have a 2.7mm diameter hole instead of 2.5mm. They were a little too
    small when constructing the prototype board.
    [power.pcb]
2010-09-01 Ensure all soldermask clearances are >= 0.125mm
    [power.pcb]
2010-09-01 Change 5V SMPS to be enabled by default
    At the moment it's not possible to reset the MSP without the beagleboard
    resetting due to the 5V SMPS being off when the 5V enable line isn't being
    driven. This changes the pull-up to a pull-down, causing the 5V SMPS to be
    enabled rather than disabled by default.
    To ensure that the 5V rail doesn't blip on when the board is first switched
    on there is a cap between the 3.3V rail and the enable line which introduces
    a delay of 10ms between the 3.3V rail coming up and the 5V SMPS being powered
    up. In this time the MSP can pull the line high, stopping the SMPS turn on
    until everything else has been checked.
    [power-power.sch]
2010-09-01 Update layout with new 5V SMPS enable pull-up/down arrangement
    [power.pcb]
2010-09-08 Update ID text with 'SR11.F' for final manufacturing run
    [power.pcb]
2010-09-09 Update layout with new ATO fuse footprints. Have 'nopaste' flag on pads
    Don't want solder paste on the pads around the ATO fuse holder pins.
    [power.pcb]
2010-09-10 Add gerbers used for final manufacture
    [power.back.gbr, power.backmask.gbr, power.backpaste.gbr, power.backsilk.gbr, power.fab.gbr, power.front.gbr, power.frontmask.gbr, power.frontpaste.gbr]
2010-09-10 Add README in gerbers directory for PCB fab
2010-09-10 Add 'Circuits per Panel' line to PCB fab README
2010-09-10 Correct instructions relating to stepped up solder mask in PCB fab README
2010-09-14 Change MSP from F247 to F169
    We can't program the 247 yet and the 169 is pin compatible.
    [power-msp.sch]
2010-09-14 Change push buttons to the 12.5mm tall ones
    [power-msp.sch]
2010-09-14 Change USB riser header to a 4 way turned-pin socket
    The header was just a place-holder until the correct component had been found.
    [power-msp.sch]
2010-09-14 Set value of 4 way header on USB riser board
    [usb-riser.sch]
2010-09-15 Add first support panel
    It is part of the lower half of the case and will support the power board,
    avoiding any connectors and components on the board.
    [case.dxf]
2010-09-15 Add second support panel
    [case.dxf]
2010-09-15 Add third support panel
    [case.dxf]
2010-09-27 Change MSP from msp430f169 to msp430f167
    The 169 isn't available from anywhere at the moment, the 167 is.
    [power-msp.sch]
2010-10-06 Add a readme for any special requirements in assembling the board
2010-10-15 Increase minicamcon cutout width in case to 9.4mm from 8.0mm
    [case.dxf]
2010-10-15 Increase the camcon cutout width on the case to 15.4mm from 15mm
    They do fit at 15mm but it is possible to mount the connectors a bit
    squiffy so the extra 0.4mm should give a bit more leeway.
    [case.dxf]
2010-10-15 Centralise the cuts between the two halves of the case between the camcons
    Should reduce the chance of them breaking off.
    [case.dxf]
2010-10-15 Correct PCB support around charging socket in the case design
    [case.dxf]
2010-10-15 Increase the cutout width of the battery camcon on the case by 0.6mm
    As with the normal camcon sockets it's possible to mount it squiffy.
    [case.dxf]
2010-10-15 Increase cutout width for charging socket on case design by 0.6mm
    [case.dxf]
2010-10-15 Add notches to the inner top panel of the case to clear nuts
    [case.dxf]
2010-10-15 Correct the layer that some lines have been drawn on
    [case.dxf]
2010-10-15 Increase the size of the holes for the ATO fuses in the top of the case
    [case.dxf]
2010-10-16 Add a cutout into the back panel of the case for JTAG and serial ribbon cables
    [case.dxf]
2010-10-16 Correct the layer that the ATO fuse holes are on for the inner top panel
    [case.dxf]
2010-10-17 Add stepped up gerbers
2010-10-18 Update PCB layout with latest schematic data
    Some of the part values have changed.
    [power.pcb]
2010-10-18 Update the assembly README file with more info
2010-10-18 Add a diagram showing how the beagleboard footprint is constructed
2010-10-18 Improve the grammar in the assembly README file
2010-10-18 Increase the clearance around the knobs in the case to 0.5mm
    [case.dxf]
2010-10-21 Correct the size/spacing of the USB riser PCB
    I've actually measured a finished board and got the right size for the
    spacing between the USB plug and the header.
    [usb-riser.pcb]
2010-12-02 Increase the size of the push-button case holes by 1mm
    Some of the boards have the push-buttons mounted slightly off-centre
    so they need more clearance in the case to ensure that they're not
    permanently pushed.
    [case.dxf]
2010-12-05 Add gerbers of a single USB riser board
    [usb-riser.back.gbr, usb-riser.front.gbr]
2010-12-05 Add a script for generating a gerbtile config file
    The generated config file is to be used with
    gerbtile (http://gitorious.org/gerbtile). The outline.pcb file contains an
    outline which fits around the stepped gerbers produced by gerbtile.
    [outline.pcb]
2010-12-05 Rename case.dxf to case-devel.dxf
    It contains a side panel which has cut-outs for development purposes: slots
    to allow the case to be closed while the MSP430 programming cable is connected,
    a serial cable is connected to the BeagleBoard and a miniUSB cable is plugged
    into the BeagleBoard.
    [case-devel.dxf]
2010-12-05 Add case.dxf, the same as case-devel.dxf but without the development cut-outs
    [case.dxf]
2010-12-05 Add interlocking wiggles to the edges of the two halves of the case
    There was a gap between the two halves of the case in the prototype so adding
    wiggles to the edges should make this less obvious. It should also add
    strength to the case as there's more edges interacting between the two halves,
    resisting shear forces.
    [case.dxf]
2010-12-06 Make the second PCB support in the case design visible
    It must have accidentally got hidden at some point.
    [case.dxf]
2010-12-12 Add button naming labels to schematic
    The firmware talks about these buttons as B0, B1, and B2. This adds
    this labelling to the schematic.
    [power-msp.sch]
2010-12-13 Attach button labels to button symbols as a comment attribute
    [power-msp.sch]
2010-12-13 Add design for silicone foam PSP-display shim
    The PSP display is held away from the electronics in the power board's
    case by a piece of silicone foam. This is the design for it.
    I've cut this out, but haven't tried it with anything yet.
    [padding.dxf]
2010-12-13 Resize and move the silicone shim cutouts
    After showing the result to a power board, it needs to look more like
    this. I made a couple of assumptions when initially inputting this.
    One of them was that the shim goes to the edge of the power board's
    case, when in fact it goes to the edge of the screen. This commit
    moves the holes and resizes them to account for this.
    TO THE LASERS!
    [padding.dxf]
2011-02-26 Remove superfluous lines from padding design
    I understand how to use QCAD more now, so can do this...
    [padding.dxf]
