andybusse/power-hw/case.dxf

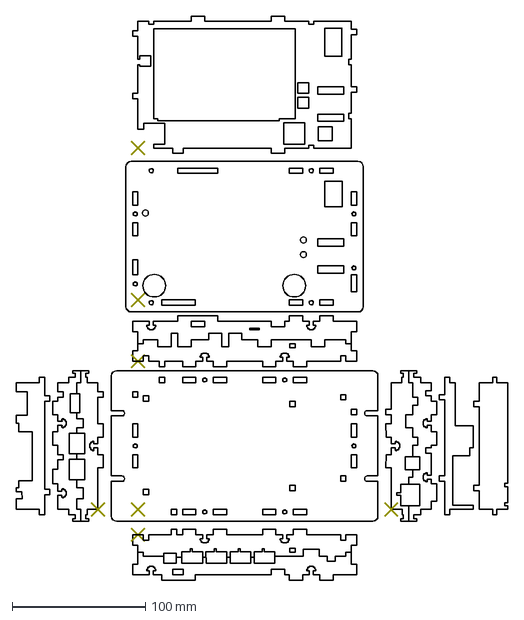
[picture p1: CAD file, 2010-12-06]
case.dxf
368.8 x 423.0 mm
